clxjaguar/MK312WIFI/(commit log)

2026-05-29 Documentation update
    Changed documentation in the paragraph about how to install arduino things
2026-06-01 Informations sent to websockets clients at new connections: Current mode, levels, ADC override status, power level range, battery level and MK312Wifi version number
2026-06-01 Documentation update about "Mode" command used with mode name and current states being sent to client at websockets connections
2026-06-01 Added: "Batt?" command (requesting battery level to be sent to clients)
2026-06-23 In case of websocket connection error, try to automatically replace https:// to http:// in the URL
2026-06-23 Unset the override button in case of another client is sending a CutLevels=0 command
2026-06-23 In case the HTML page file is opened directly in a browser (when debugging?), prompt the user for the MK312Wifi IP address
2026-09-08 Arduino esp8266 core v3.1.2 had a regression on network (packets losts with some AP). This is compiled with core version 3.1.1.
2026-09-23 Once handshake with the mk312 is successful, ignore errors with it (in place of blinking leds the error code)
    [MK312Wifi.ino]
